NicolasCarnevali/CO2-CSS811/ScannerI2C_25_Mars_sur_Carte_2_capteurs/Read_me.txt

Explication de la version : 

Scanner I2C qui change le port de lecture du MUX entre 0 et 1
LED_R est allumée lorsque Port = 0.
LED_R est éteinte lorsque Port = 1.
