NicolasCarnevali/CO2-CSS811/Rapport des seances/CSS811.docx

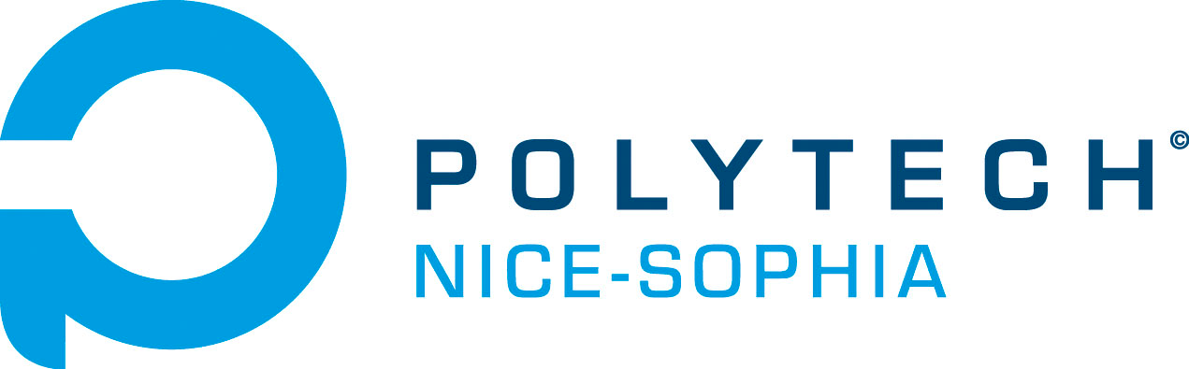
[picture p3: figure]
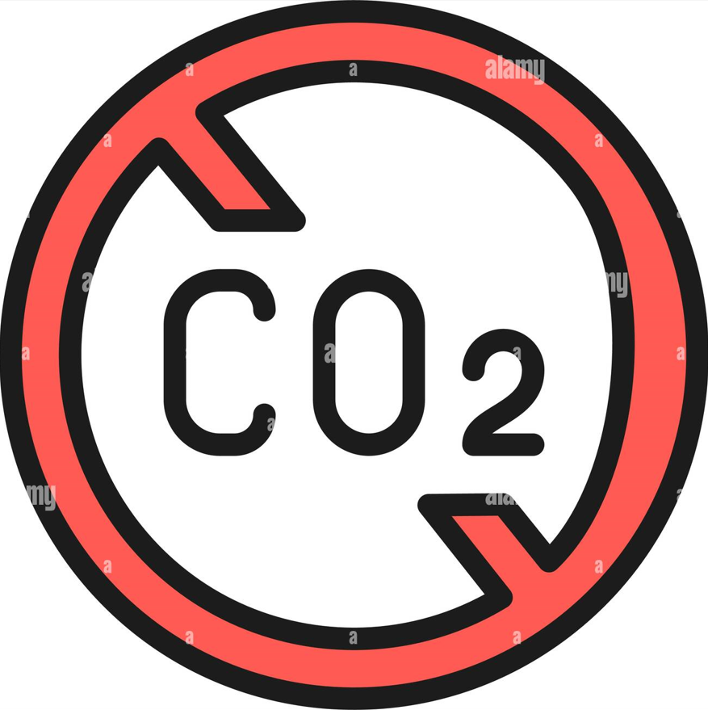
[picture p4: figure]

Project d'électronique

Traitement CO2

I. Les étapes du projet
1) Nous avons commencé par souder la nouvelle carte avec tous les composants sauf les nouveaux capteurs.
2) Nous avons téléchargé l’IDE Arduino pour essayer de tester quelques composants sur la carte telle que les leds et l’esp32…
3) Souder les nouveaux capteurs sur la nouvelle carte et essayer de les tester
4) créer un git pour le projet

Elyes Zantour,Nicolas Carnevali

Elyes Zantour et Nicolas Carnevali
