NicolasCarnevali/CO2-CSS811/Rapport des seances/Nicolas/Rapport CARNEVALI Nicolas.odt

Projet Electronique CO2 :

(06/11) : Début de projet ou bien « Que des problèmes… »

1. Soudure CMS de la carte + soudure du capteur
2. Lecture de la doc du capteur (si le CS est à 1 le capteur utilise l’I2C, s’il est à 0 le capteur utilise le SPI)
3. Essai de plusieurs sketchs pour détecter l’adresse I2C du capteur (Adresse renseigné sur la doc de ce dernier à savoir : 0x53 si le bit ADD est à HIGH et 0x52 s’il est à LOW)

Résultat négatif

4. Ecran bleu du PC de travail lors du téléversement
5. Intervention de l’IT, le PC n’était pas récupérable donc changement
6. Réinstallation des logiciels
7. Test de la solution une nouvelle fois et nouvel échec (pas de réponse du capteur)

(20/11) : Prise en main de la communication entre capteur et PC ou bien « Nouvelle désillusion »

1. Test de certains sketchs trouver sur le net pour détecter l’adresse I2C d’un capteur Echec
2. Test scan I2C avec l’ancienne carte Succès
3. Modification du sketch précédent en fonction de la datasheet du composant ENS 160 Echec (on ne sait pas si c’est le câblage ou bien le code qui ne fonctionne pas)
4. Soudure des 3 fils permettant la communication (permet d’éliminer le défaut de câblage)
5. Test : Echec

(04/12) : Recherche adresse I2C d’un capteur ou bien « Des hauts et des bas »

1. Changement (de nouveau) de PC de travail donc réinstallation des logiciels
2. Reprise du travail fait la séance précédente, vérification du sketch OK
3. On a réussi à avoir une adresse I2C brièvement mais la communication n’est pas pérenne.
4. Vérification des soudures
5. Nouveau test Echec
6. On isole le capteur et l’ESP32 de la carte PCB
7. Test isolé Adresse I2C Réussis à détecter l’adresse I2C
8. Test isolé CO2 Réussis à capter un taux de CO2 cohérent, augment si on souffle dessus puis diminue
9. Test isolé Température Test réussi, augmente lorsque l’on place le capteur dans la ligne d’effet du pistolet à air chaud
10. Retour des tests sur la carte sans changer les sketchs Echec
11. Modification de câblage sur la carte pour ne pas utiliser la broche 12 (Initialisation de l’ESP)
12. Test I2C scanning Nouvel échec cuisant …
13. Changement de capteur et changement de l’emplacement du capteur sur la carte (car 1er capteur soudé) encore et toujours la même chanson … Echec !
14. Réalisation de la soudure de jonction (le capteur n’était pas alimenté sur la carte depuis car cette jonction n’était pas présente …)
15. Test détection du capteur Succès
16. Test CO2 Succès
17. Test détection simultané de 2 capteurs avec 2 adresses différentes Echec
18. Test détection différé de 2 capteurs (1 en I2C et 1 en SPI) Echec
19. Seule solution : Redessiner une nouvelle carte pouvant alimenter 1 capteur à la fois
