NicolasCarnevali/CO2-CSS811/Compte Rendu Elec.odt

Compte Rendu Projet électronique CO2 2025

Séance 1 (25/02) :

Objectif :

- Reprise du projet de l’année 2024/2025 (Traitement CO2)
- Détection du problème précédent (impossible de trouver l’adresse du capteur)

Tâches effectuées :

- Tests du programme précédent Impossible de trouver une adresse I2C
- Check du hard de la carte
  - Regard du sens des PINS
  - Détection du problème de soudure (capteur soudé à l’envers)
  - Vérification avec le 3,3V sur les pins de la carte
- Dessoudure du capteur monté à l’envers
- Soudure du nouveau capteur en ayant pris soin de le souder dans le bon sens
- Test du code permettant de retrouver l’adresse I2C Le code détecte une adresse I2C mais pas forcément correct

Tâches à effectuer ultérieurement :

- Vérifier l’adresse I2C du capteur via la datasheet
- Brocher 1 autre capteur (puis 2 après vérification de la détection du premier)
- Créer un petit sketch permettant de faire permuter le multiplexeur I2C pour communiquer avec 1 capteur à la fois

Séance 2 (28/02) :

Objectif :

- Déceler pourquoi on trouve 0x70 comme adresse I2C et pas 0x52

Tâches effectuées :

Révision du code :

- Check des CS bien à 1 (bit permettant le protocole I2C)
- Check de l’activation de MEASURE (variable permettant d’alimenter le MUX)
- Check des entrées du MUX :

A0 | A1 | A2 | Résultat
0 | 0 | 0 | 0x70
0 | 0 | 1 | 0x74
0 | 1 | 0 | 0x72
0 | 1 | 1 | 0x76
1 | 0 | 0 | 0x71
1 | 0 | 1 | 0x75
1 | 1 | 0 | 0x73
1 | 1 | 1 | 0x77

- Ainsi, on peut voir que A0 est le bit de poids faible et que A2 est le bit de poids fort.
- Essai de création de sketch pour lire le taux de CO2 et/ou la température sur les différentes adresses en fonction de A0/A1/A2
- Proposition d’essai « simplifié » avec 1 ESP32 directement connecté à l’ENS.

Tâches à effectuer :

- Créer un sketch simple pour faire des mesures de CO2/température avec un montage simple
- Tester sur notre carte en cas de succès

Séance 3 (10/03) :

Objectif :

- Travail sur le capteur connecté directement à l’ESP32

Tâches effectuées :

- Branchement du capteur à un ESP32
- Travail sur le sketch pour vérifier qu’il était valide
- Recherche de debug pour savoir pourquoi des données erronées apparaissent à l’écran

Tâches à effectuer :

- Changer d’IDE Arduino pour voir si les bugs viennent de ce dernier
- Changement d’ESP32

Séance 4 (11/03) :

Objectif :

- Travail sur le capteur connecté directement à l’ESP32 (après changement)

Tâches effectuées :

- Branchement du capteur à une nouvelle version de carte d’interfaçage d’ESP32
- Utilisation du sketch sur le capteur et détection des adresses I2C du capteur de CO2 et capteur de température.
- Vérification de comment mettre le capteur en I2C

Comment mettre le capteur dans le mode de communication I2C :

- Le capteur peut passer de I2C à SPI mais la réciproque n’est pas vraie.
- Le capteur prend le premier mode venu selon CS.
- Si le capteur est en mode SPI, un redémarrage du capteur est nécessaire.

Tâches à effectuer :

- Faire des mesures et voir si elles sont cohérentes.
- Essayer de détecter le capteur sur la carte maintenant que l’on est sur du sketch à utiliser et que l’on détecte bien le capteur.

Séance 5 (24/03) :

Objectif :

- Détecter les capteurs sur la carte.

Tâches effectuées :

- Test du sketch vérifié à la séance précédente (adapté) sur la carte
- Lecture de la datasheet du MUX I2C.
- Recherche des résistances de pull-up du bus I2C (sur la carte électronique et sur la carte capteur)
- Lecture du schematic de la carte capteur
- Ajout de tension 3,3V pour Vin sur ESP32 isolé

Tâches à effectuer :

- Faire des mesures et voir si elles sont cohérentes.

Séance 5 (24/03) :

Objectif :

- Faire des mesures de CO2 sur le capteur présent sur la carte
- Faire des mesures de Température sur le capteur présent sur la carte
- Faire des mesures de CO2 et de température simultanément sur la carte
- Souder un des deux capteurs restants
- Faire des mesures sur un capteur puis sur un autre

Tâches effectuées :

- Création du sketch permettant les mesures CO2 sur le capteur via la bibliothèque ScioSense_ENS16x.h
- Création d’un sketch permettant les mesures de température sur le capteur via la bibliothèque AHT20.h
- Rassemblement des 2 sketchs pour lire en simultané le taux de CO2 et la température/ humidité Etape vérifiée sans problème
- Soudure du 2ème capteur
- Création d’un sketch permettant de changer l’aiguillage amenant aux capteurs (MUX) et de lire les différents adresses I2C (les adresses I2C sont les mêmes donc la LED_R me permet de connaitre l’état du MUX)
- Création d’un sketch permettant de lire les différentes données en simultané avec les 2 capteurs. Les mesures sont faites-les une après les autres car on doit changer l’état du MUX.

Tâches à effectuer :

- Rajouter le dernier capteur
- Créer des sketchs permettant les mesures sur les 3 différents capteurs.

Séance 6 (07/04) :

Objectif :

- Ajout du dernier capteur
- Modification du sketch afin de lire des valeurs consécutivement sur les 3 capteurs

Tâches effectuées :

- Soudure du dernier capteur
- Test du dernier capteur
- Création d’un sketch avec un start de chaque ens160 mais avec une déclaration et une variable problème de valeurs TVOC (capteur ENS160)

Tâches à effectuer :

- Elucider pourquoi on a une mauvaise lecture des mesures Créer un sketch avec différentes déclaration de l’ens160 (test sur carte 3 capteurs amélio).

Séance 7 (11/04/25)

Objectif :

- Créer et tester le code afin de lire les mesures consécutivement.
- Formater les mesures pour l’insérer dans un document csv facilement

Tâches effectuées :

- Test du dernier sketch (Test_Mesure_sur_carte_avec_3_capteurs_amelio)
- Dessoudure du 3ème capteur pour vérifier que ce n’est pas ce dernier qui nous fausse les mesures.
- Formatage de la lecture des valeurs que sur 1 seul capteur (Test_Mesure_sur_carte_avec_3_capteurs_amelio)

Tâches à effectuer :

- Trouver pourquoi les ens160 1 et 2 n’ont jamais de mise à jour d’information (ens160_1/2.update () toujours false) donc aucune lecture de données. peut-être le temps de calibration
- Faire des campagnes de mesure sur le capteur 0 (fonctionnel)

CARNEVALI NICOLAS, ELSE4 FISA Année 2024/2025
