NicolasCarnevali/CO2-CSS811/Table des PINS.ods

NAME | PIN ESP | Correspondance Capteur : Carte | Légende : | Capteur 1 | Capteur 2 | Capteur 3
ADD1 | 2
ADD2 | 4
RFM_NSS | 5
ADD3 | 12 | ADD : ADD3
MEASURE | 13
RFM_RST | 14
RST_CO2 | 15
WAK1 | 16
INT1 | 17
RFM_SCK | 18
MISO | 19
NC | 20
SDA | 21
SCL | 22
MOSI | 23
LED_G | 25
WAK2 | 26
WAK3 | 27 | Chip Select (CS) : WAK3
INT2 | 32
LED_R | 33
VBAT | 34
INT3 | 35 | INT : INT3
