NicolasCarnevali/CO2-CSS811/Eagle_PCB/ESP_CO2_V0.30.sch

## EAGLE design Eagle_PCB/ESP_CO2_V0.30.sch (2024-02-16)

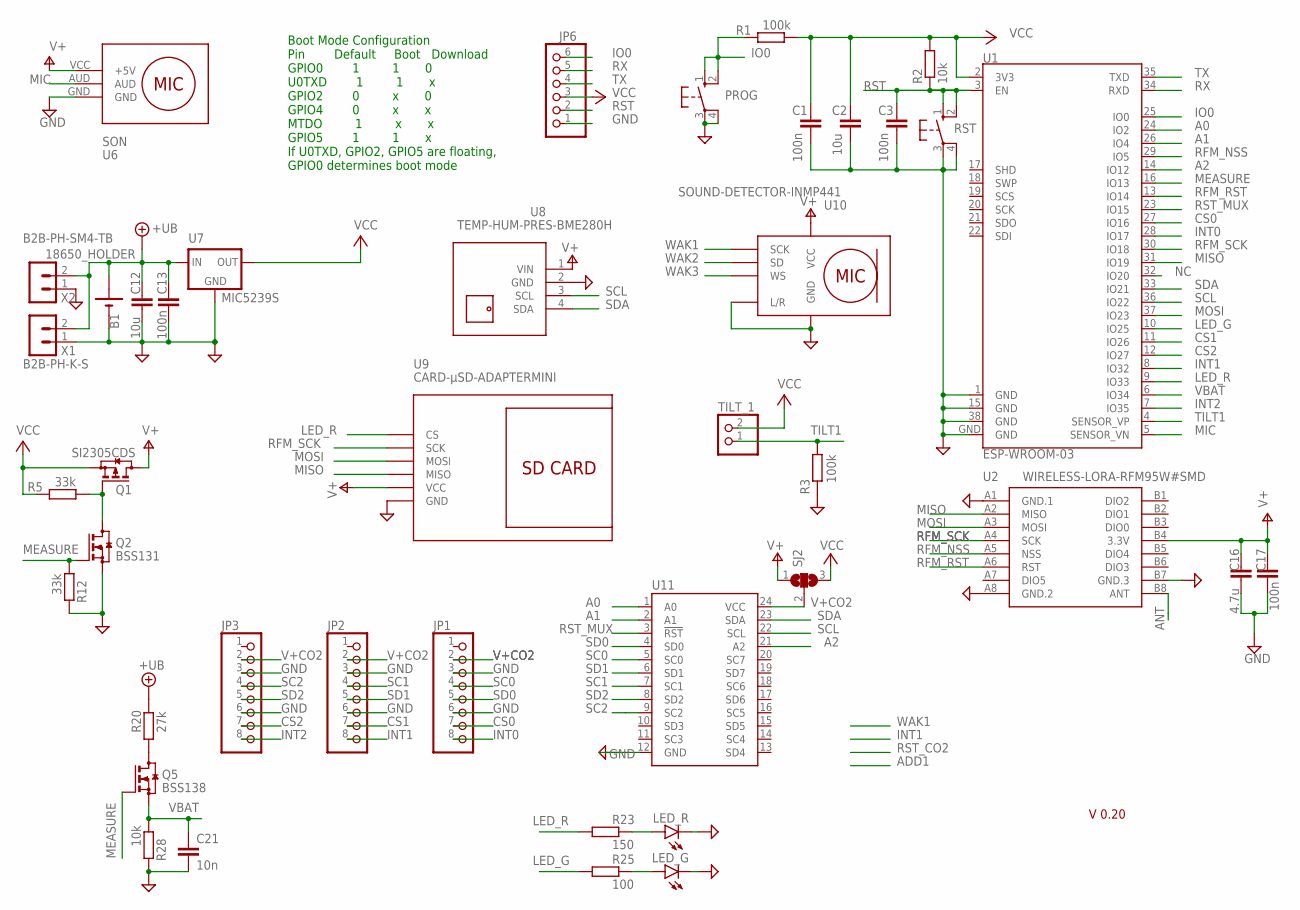
[picture p32: schematic ESP_CO2_V0.30.sch]

Parts:
B1: 18650_HOLDER; 18650
C1, C3, C13, C17: 100n; C1206
C2, C12: 10u; C1206
C16: 4.7u; C1206
C21: 10n; C1206
JP1, JP2, JP3: PINHD-1X8; 1X08
JP6: PINHD-1X6/90; 1X06/90
LED_G: LEDSML0805; SML0805
LED_R: LEDSML0805; SML0805
PROG: 10-XX; B3F-10XX
Q1: SI2305CDS; SOT23
Q2: BSS131; SOT23
Q5: BSS138; SOT23
R1, R3: 100k; R1206
R2, R28: 10k; R1206
R5, R12: 33k; R1206
R20: 27k; R1206
R23: 150; R1206
R25: 100; R1206
RST: 10-XX; B3F-10XX
SJ2: SJ2W; SJ_2
TILT_1: PINHD-1X2; 1X02
U1: ESP-WROOM-03
U2: WIRELESS-LORA-RFM95W#SMD
U6: SON
U7: MIC5239S; SOT223
U8: TEMP-HUM-PRES-BME280H; TEMP-HUM-PRES-BME280-H
U9: CARD-µSD-ADAPTERMINI; CARD-MINI--µSD-READER
U10: SOUND-DETECTOR-INMP441
U11: PCA9548A; TSSOP28
X1: B2B-PH-K-S
X2: B2B-PH-SM4-TB

Connections:
+UB: B1.+, C12.1, C13.1, R20.2, U7.1 (IN), X1.2, X2.2
A0: U1.24 (IO2), U11.1 (A0)
A1: U1.26 (IO4), U11.2 (A1)
A2: U1.14 (IO12), U11.21 (A2)
ANT: U2.B8 (ANT)
CS0: JP1.7, U1.27 (IO16)
CS1: JP2.7, U1.11 (IO26)
CS2: JP3.7, U1.12 (IO27)
GND: B1.-, C1.2, C2.2, C3.2, C12.2, C13.2, C16.2, C17.2, C21.2, JP1.3, JP1.6, JP2.3, JP2.6, JP3.3, JP3.6, JP6.1, LED_G.C, LED_R.C, PROG.3, PROG.4 (P1), Q2.2 (S), R3.2, R12.2, R28.2, RST.3, RST.4 (P1), U1.1 (GND), U1.15 (GND), U1.38 (GND), U1.GND, U2.A1 (GND.1), U2.A8 (GND.2), U2.B7 (GND.3), U6.GND, U7.2 (GND), U8.2 (GND), U9.GND, U10.GND, U10.L/R, U11.12 (GND), X1.1, X2.1
INT0: JP1.8, U1.28 (IO17)
INT1: JP2.8, U1.8 (IO32)
INT2: JP3.8, U1.7 (IO35)
IO0: JP6.6, PROG.1 (S), PROG.2 (S1), R1.2, U1.25 (IO0)
LED_G: R25.1, U1.10 (IO25)
LED_R: R23.1, U1.9 (IO33), U9.CS
MEASURE: Q2.1 (G), Q5.1 (G), R12.1, U1.16 (IO13)
MIC: U1.5 (SENSOR_VN), U6.AUD
MISO: U1.31 (IO19), U2.A2 (MISO), U9.MISO
MOSI: U1.37 (IO23), U2.A3 (MOSI), U9.MOSI
unnamed: Q1.1 (G), Q2.3 (D), R5.1
unnamed: Q5.3 (D), R20.1
unnamed: LED_R.A, R23.2
unnamed: LED_G.A, R25.2
NC: U1.32 (IO20)
RFM_NSS: U1.29 (IO5), U2.A5 (NSS)
RFM_RST: U1.13 (IO14), U2.A6 (RST)
RFM_SCK: U1.30 (IO18), U2.A4 (SCK), U9.SCK
RST: C3.1, JP6.2, R2.1, RST.1 (S), RST.2 (S1), U1.3 (EN)
RST_MUX: U1.23 (IO15), U11.3 (!RST)
RX: JP6.5, U1.34 (RXD)
SC0: JP1.4, U11.5 (SC0)
SC1: JP2.4, U11.7 (SC1)
SC2: JP3.4, U11.9 (SC2)
SCL: U1.36 (IO22), U8.3 (SCL), U11.22 (SCL)
SD0: JP1.5, U11.4 (SD0)
SD1: JP2.5, U11.6 (SD1)
SD2: JP3.5, U11.8 (SD2)
SDA: U1.33 (IO21), U8.4 (SDA), U11.23 (SDA)
TILT1: R3.1, TILT_1.1, U1.4 (SENSOR_VP)
TX: JP6.4, U1.35 (TXD)
V+: C16.1, C17.1, Q1.3 (D), SJ2.1, U2.B4 (3.3V), U6.VCC (+5V), U8.1 (VIN), U9.VCC, U10.VDD (VCC)
V+CO2: JP1.2, JP2.2, JP3.2, SJ2.2, U11.24 (VCC)
VBAT: C21.1, Q5.2 (S), R28.1, U1.6 (IO34)
VCC: C1.1, C2.1, JP6.3, Q1.2 (S), R1.1, R2.2, R5.2, SJ2.3, TILT_1.2, U1.2 (3V3), U7.3 (OUT)
WAK1: U10.SCK
WAK2: U10.SD
WAK3: U10.WS

Notes on the sheet:
Boot Mode Configuration Pin Default Boot Download GPIO0 1 1 0 U0TXD 1 1 x GPIO2 0 x 0 GPIO4 0 x x MTDO 1 x x GPIO5 1 1 x If U0TXD, GPIO2, GPIO5 are floating, GPIO0 determines boot mode
V 0.20
