NicolasCarnevali/CO2-CSS811/(commit log)

2023-12-03 Rapports Elyes des séances
    Les rapports de Elyes des séances du 6/11/2023 et du 20/11/2023
2023-12-04 Table des pins de l'esp 32
    [Table des PINS.ods]
2023-12-04 Update Table des PINS.ods
    [Table des PINS.ods]
2023-12-04 Sketch Arduino
    1-NEW sketch to measure the temperature and humidity
    2- Update the I2C scanner to get the address of the sensor
2023-12-04 Create Rapport_ElyesZantour_4122023.docx
    Rapport Elyes de la séance du 4-12-2023
2024-02-13 Modification seance du 04/12 et 22/12
    Ajouter le sketch de mesure du CO2, adapter le code du I2C scanner, rajouter les rapports des deux séances et modifier le schématique de la carte sur eagle
2024-02-16 Seance du 16/02/2024
    J'ai reussi a faire fonctioner les 3 capteurs sur la carte dev ESP32, carte grille, nouveau schematique
    [ESP_CO2_V0.30.sch]
